kayensmet/Self-driving-bicycle-2025-2026/README.md

# Self-driving-bicycle-2025-2026-
This is a central repository storing all code, 3D models, scans, and research gathered during the 2025-2026 Self-Driving Bicycle project. It contains our entire year's progress, archived and organized for next year's team to pick up and use.
