kayensmet/Self-driving-bicycle-2025-2026/docs/steering/index.md

<script>
MathJax = {
  tex: {
    inlineMath: [['$', '$'], ['\\(', '\\)']]
  }
};
</script>

<script defer
src="https://cdn.jsdelivr.net/npm/mathjax@3/es5/tex-chtml.js">
</script>
# Steering System — IB3 Self-Driving Bicycle 2025–2026

**Team:** Group 1 (Robin, Quinten, Maxime, Lars, Noah, Lee) & Group 2 (Milan, Kayen, Thibaut, Toon, Simon V, Simon VK)  
**Note:** Both groups took a different route on the steering system. We will try to separate them out as much as possible. **The final product delivered here is GROUP 2's bicycle**, but we still want to share all the information we gathered.

For full slides, and detailed comparisons, refer to the [final presentation (PDF)](../assets/FinalIB3.pdf).

---

## Contents

1. [Problem statement](#problem-statement)
2. [Research: dimensioning a motor](#research-dimensioning-a-motor)
3. [Plan A — Belt Drive (group 2)](#plan-a-belt-drive)
4. [Plan B — Chain Drive (group 2)](#plan-b-chain-drive)
5. [Plan Direct Drive (group 1)](#plan-direct-drive)

---

## Problem statement

The goal is a bicycle that stays upright and moves without any physical human assistance. The steering system makes steering the bike possible.

---

## Research: dimensioning a motor

A portable luggage scale was used to pull on the steering wheel of the bike, to find the maximum pull strength required to move the steering wheel. Expirementally was found that a force of $F = 19,62 N (= 2 kg)$ at a distance of $30 cm$ was required to move the steering wheel. Using the moment's law of static mechanics:

$$M_{N}= F \cdot r \cdot sin(\alpha) = 19,6 N \cdot 0,3 m \cdot sin(90\circ)= 5,88 \cdot 1 Nm \approx 60 kg \cdot cm$$

There's a handy [convertor tool online](https://lucidar.me/en/unit-converter/convert-torque-in-n-m-to-kg-cm/) to help convert Nm to kg cm. A lot of (servo) motors online will list their torque as kg cm. 

Group 1 took a 300% safety margin into account and used a moment's force of:

$$M_{N}= 3 \cdot F \cdot r \cdot sin(\alpha) = 3\cdot  19,6 N \cdot 0,3 m \cdot 1= 5,88 Nm \approx 180 kg \cdot cm$$

---

## Plan A Belt Drive (group 2)

Group 2's first approach was using a belt drive. They tried using a 6mm wide 2GT type belt, known for their use in 3d printers.
The belt was bought on ALiExpress, as a package with 120 teeth gear (bore 25mm, same as the steering post diameter). This build was accompanied by a 3d printed gear (melted into the metal accessory arm that came with the servo).
This did not end up working. Reason: the belt started slipping while steering, making it impossible to reliably steer.

---

## Plan B Chain Drive (group 2)

A quick and dirty solution to the slipping belt was made (literally hot glued) on top of the old belt gears: bike gears with a chain.
This chain performed much better than the belt, because it couldn't slip as easily.

**Why this works:**
- chain does not dynamically flex like a belt
- near 1:1 gear ratio makes setting steering angle very easy: servo angle = steering angle

**Downsides to be aware of:**
- there is some play (backlash) in the chain. This will probably end up in vibrations on higher speeds 
- installing and adjusting is a cumbersome process: screws involved.

For hardware details (servo PCB, wiring), see [Hardware Implementation](hardware_implementation.md).

---

## Plan Direct Drive (Group 1)

While Group 2 opted for complex, high-maintenance transfer systems, Group 1 committed to a **Direct Drive Gear System**. By eliminating intermediate tension components like belts or chains, a direct drive inherently offers the highest potential for instantaneous steering response, minimal energy loss, and robust mechanical coupling—critical attributes for keeping a self-driving bicycle perfectly upright.

### The Engineering Journey: Taming the Torque
Because Group 1 rigorously calculated a 300% safety margin, our system had to handle a massive torque of $M_{N} = 180 \text{ kg}\cdot\text{cm}$ ($5.88 \text{ Nm}$). Managing this industrial-grade power from our high-performance servo motor required a deliberate, iterative material science approach:

* **Iteration 1 (Pure 3D Printing):** Rapid prototyping with standard 3D-printed gears proved that standard PLA/PETG infill structures couldn't withstand the raw, crushing shear stress generated by our high-torque motor.
* **Iteration 2 (Laser-cut MDF):** Switching to custom laser-cut gears provided excellent profile accuracy, but standard-thickness materials still yielded under the immense localized bending moments at the axile center.
* **The Masterstroke (Hybrid Material Composites):** To perfectly balance weight, precision, and brutal strength, we engineered a hybrid drivetrain. By pairing an ultra-thick, heavy-duty hardwood gear on the main steering column with a precision 3D-printed driving gear on the servo, we achieved the perfect friction-and-strength coefficient. This custom-engineered pairing completely neutralized the motor's immense force, turning raw torque into flawless, reliable steering control.

### How it works
The servo shaft is connected to a gear, which is then connected to another gear which is connected on the steering axle. When servo turns clockwise, the steer will move counterclockwise and vice versa. 

### Result
ToDo: images?

---

## Possible best solution (not implemented)
Near the end of the project we stumbled apon possibly the best solution. This solution is called a Capstan Drive. This is a bit of a niche which is why we mention it here. The benefit of this design lies mostly in the fact that it inherently has no backlash which is the biggest issue to remain in the steering setups of both teams. It is also Very 3d print friendly and uses rope which is cheap. For more information check out the following site: https://www.aaedmusa.com/projects/capstandrive.

---
*IB3 — KU Leuven Campus Gent — 2025–2026*
