kayensmet/Self-driving-bicycle-2025-2026/docs/communication/controller.jpg

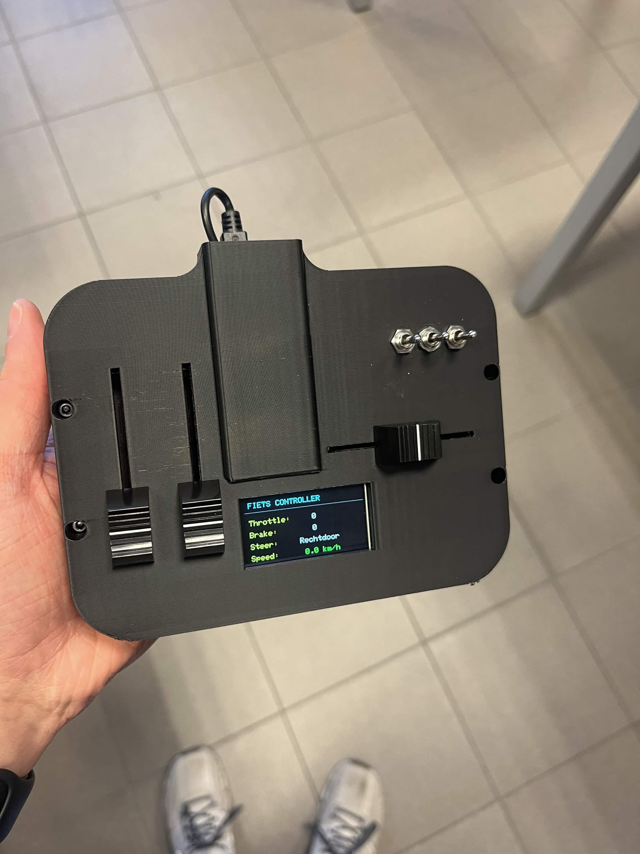
docs/communication/controller.jpg
