kayensmet/Self-driving-bicycle-2025-2026/docs/drive/AansluitingThrottle.png

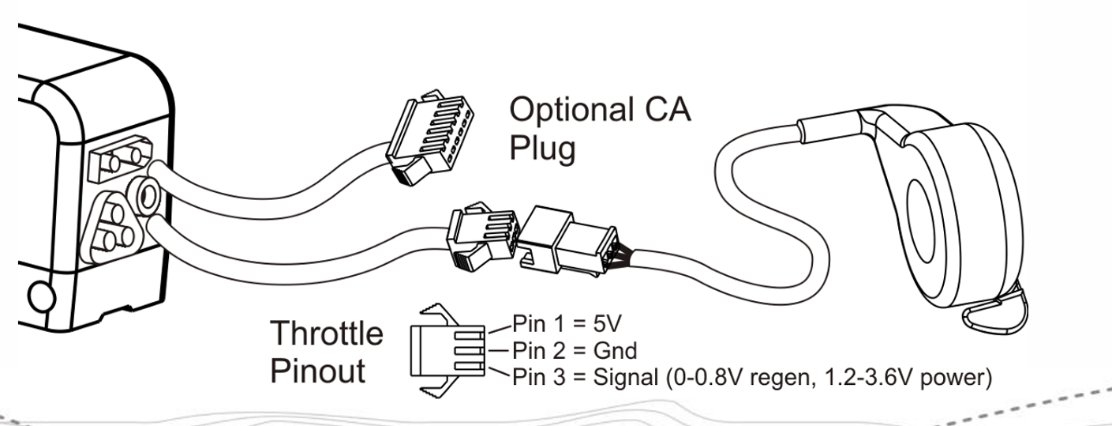
docs/drive/AansluitingThrottle.png
