kayensmet/Self-driving-bicycle-2025-2026/src/balance/3D_files/Top_cage.stl

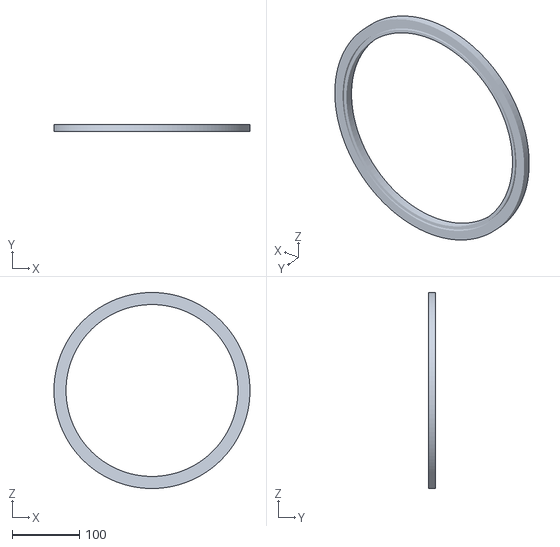
[picture p18: CAD file, 2026-05-14]
src/balance/3D_files/Top_cage.stl
292.0 x 10.0 x 292.0
