kayensmet/Self-driving-bicycle-2025-2026/src/balance/3D_files/Bracket/Bracket_cage(30mm).stl

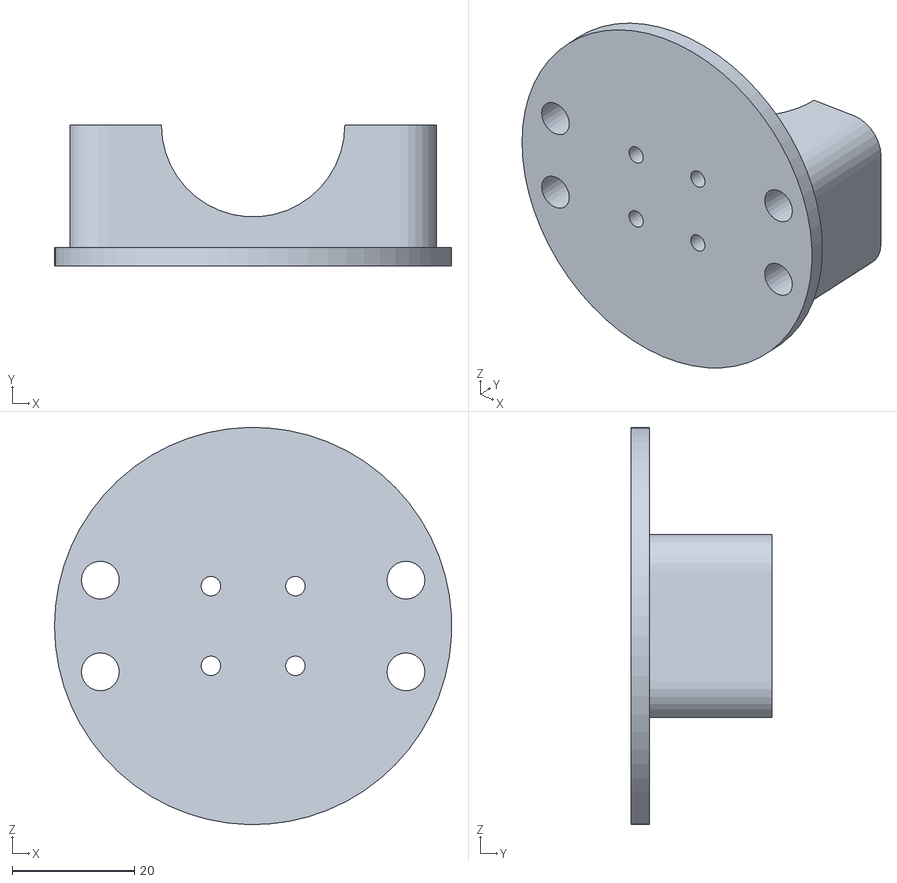
[picture p20: CAD file, 2026-05-14]
src/balance/3D_files/Bracket/Bracket_cage(30mm).stl
65.0 x 23.0 x 65.0
