kayensmet/Self-driving-bicycle-2025-2026/(list of files, cad)

Other CAD files:
src/balance/3D_files/Bracket/Bracket_cage(31mm).stl
src/balance/3D_files/Bracket/Bracket_cage(29mm).stl
src/balance/3D_files/Esc_bracket.f3d
src/balance/3D_files/Imu_bracket.f3d
