kayensmet/Self-driving-bicycle-2025-2026/(commit log)

2026-05-14 summary of powerpoint
    This is an AI generated summary
2026-05-14 Insert images
2026-05-14 Update image path for Torque Arm in documentation
2026-05-14 Implement initial PID balance control system
    - Added PID balancing logic for the self-balancing bicycle
    - Added DShot library integration for drone motors
    - Added webserver for live PID parameter tuning
    - Added response graphs for PID analysis and debugging
2026-05-14 Implement initial LQR balance control system
    - Added LQR balancing logic for the self-balancing bicycle
    - Added webserver for live LQR parameter tuning
    - Added response graphs for LQR analysis and debugging
    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
2026-05-14 ESP32 documentation of drive
    Added detailed information about the PCB and ESP32 control system, including power supply, hall sensor, motor control connections, and additional features like the buzzer, front light, and rear light.
2026-05-14 Remove duplicate text
    Removed motor control connections section from documentation.
2026-05-14 added Fusion files
    [Bottom_noholes.stl, Bracketv2.stl, Esc_bracket.f3d, Imu_bracket.f3d, Top_no holes.stl]
2026-05-14 edit 3D files
    added 3D files and organised
    [Bottom_cage.stl, Bracket_cage(29mm).stl, Bracket_cage(30mm).stl, Bracket_cage(31mm).stl, Bracket_cage(32mm).stl, Esc_bracket.f3d, Imu_bracket.f3d, Top_cage.stl]
2026-05-15 Simulatie inverted pendulum met PID
    PID-regeling van een inverted pendulum, met twee krachten bovenaan de pendulum die de dronemotoren representeren.
    Aanpasbare parameters zoals, gewicht, stuwkracht motoren, zwaartepunt.
    [target-imgui_pid-Debug-d4fa053cbf5ee39d908e.json]
2026-05-15 create steering index.md
2026-05-15 Update README with simulation details and features
    Added detailed information about the inverted pendulum PID simulation, including features, adjustable parameters, PID controller tuning, technologies used, and real-time graph visualizations.
2026-05-15 Update steering index.md
    added script for inline LaTeX
2026-05-16 kleine tweaks aan ballance documentatie
    fix foutje dimensionering plan B, kleine aanpassing bij sensoren, literatuur voor een improvement toegevoegd en homing procedure als improvement voorgesteld
2026-05-16 Update hardware_implementation.md
    something was wrong with table of esc, fixed
2026-05-20 Add Servo control implementation using ESP-NOW
2026-05-24 changed couple details to direct dirve text
